gregdavill/gpsLogger/README.md

# gpsLogger

MSP430F55xx based GPS logger, with USB MSC for log retrieval
