gregdavill/gpsLogger/fw/gpsLoggerBootloader/Memory Map.png

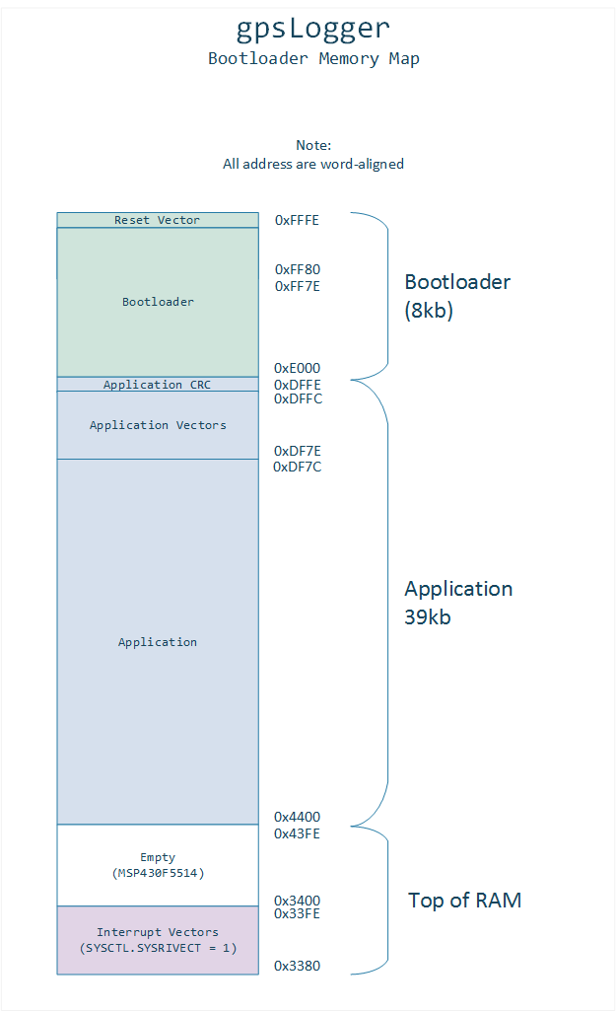
fw/gpsLoggerBootloader/Memory Map.png
