gregdavill/gpsLogger/hw/v2.3.a/3d/FH34SRJ-6S-0.5SH.igs

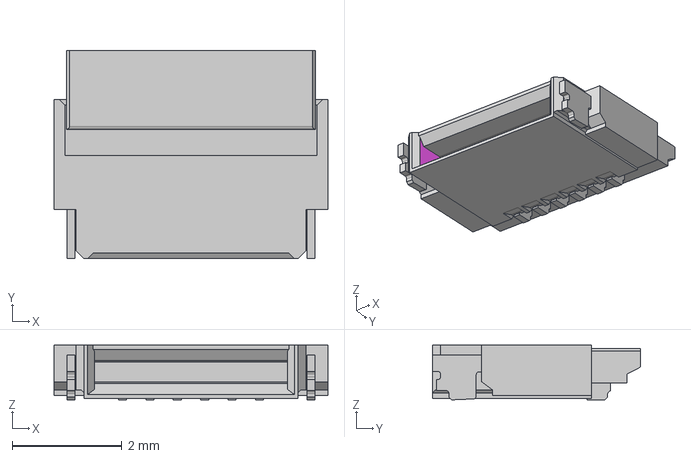
[picture p2: CAD file, 2021-10-18]
hw/v2.3.a/3d/FH34SRJ-6S-0.5SH.igs
5.00 x 3.80 x 1.00 mm
