gregdavill/gpsLogger/hw/v2.3.a/3d/EVQ-P1-9FKYD_P04_9P1-05M.STEP

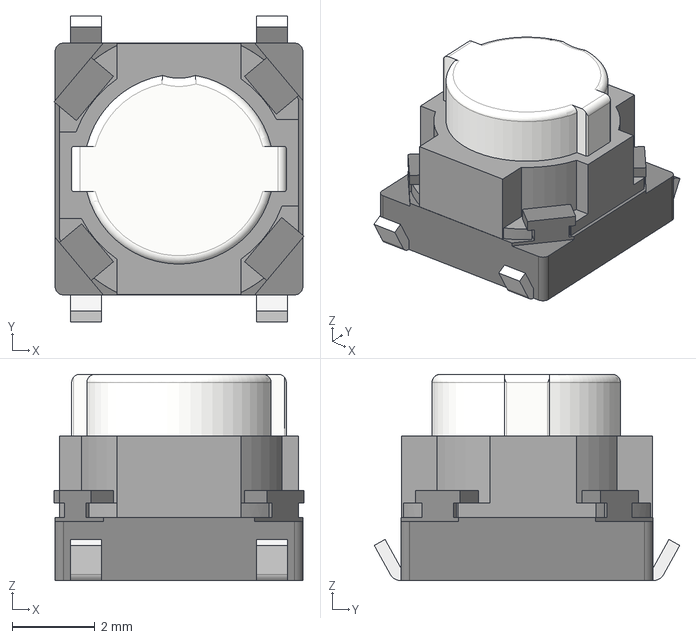
[picture p3: CAD file, 2021-10-18]
hw/v2.3.a/3d/EVQ-P1-9FKYD_P04_9P1-05M.STEP
6.06 x 7.40 x 5.00 mm
