gregdavill/gpsLogger/hw/v2.3.a/3d/10132328_usbc_vertical.step

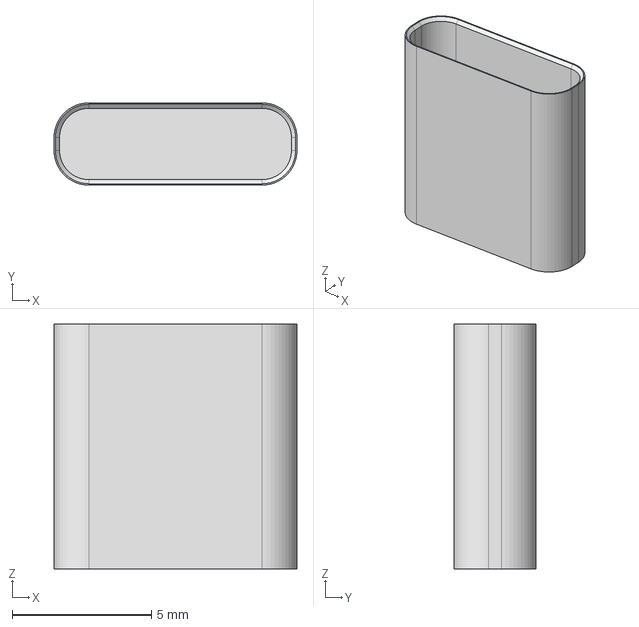
[picture p4: CAD file, 2021-10-18]
hw/v2.3.a/3d/10132328_usbc_vertical.step
8.74 x 2.96 x 8.80 mm
