gregdavill/gpsLogger/hw/v2.3.a/main-board/gps-logger-main-sch.pdf

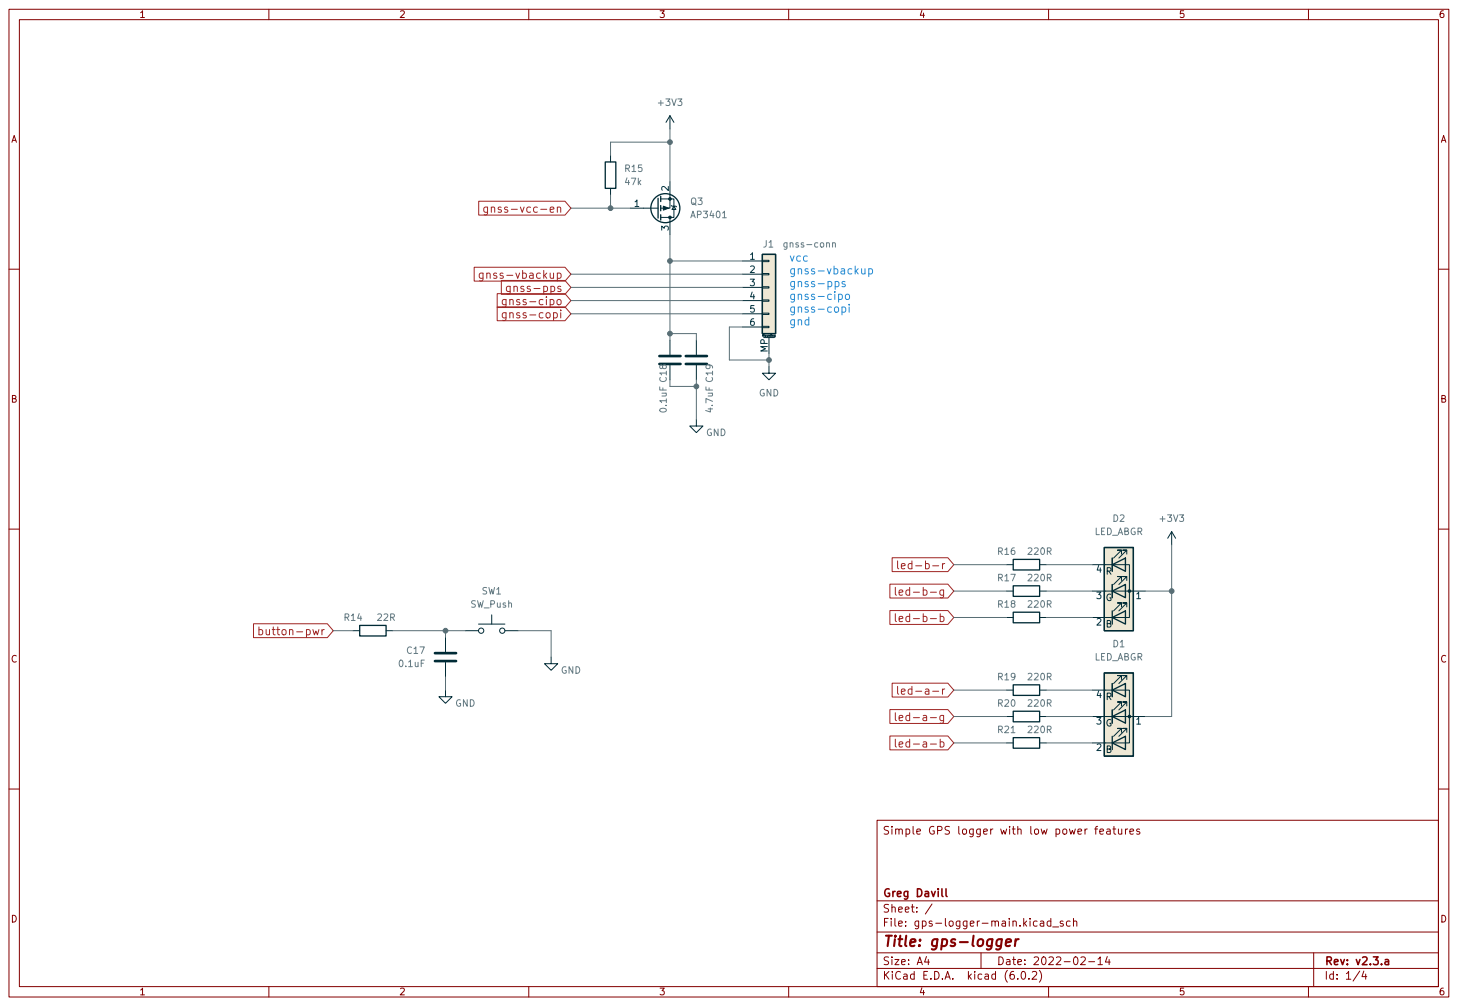
[picture p5: page 1]

Simple GPS logger with low power features

File: gps-logger-main.kicad_sch Sheet: / Greg Davill

Id: 1/4 Title: gps-logger

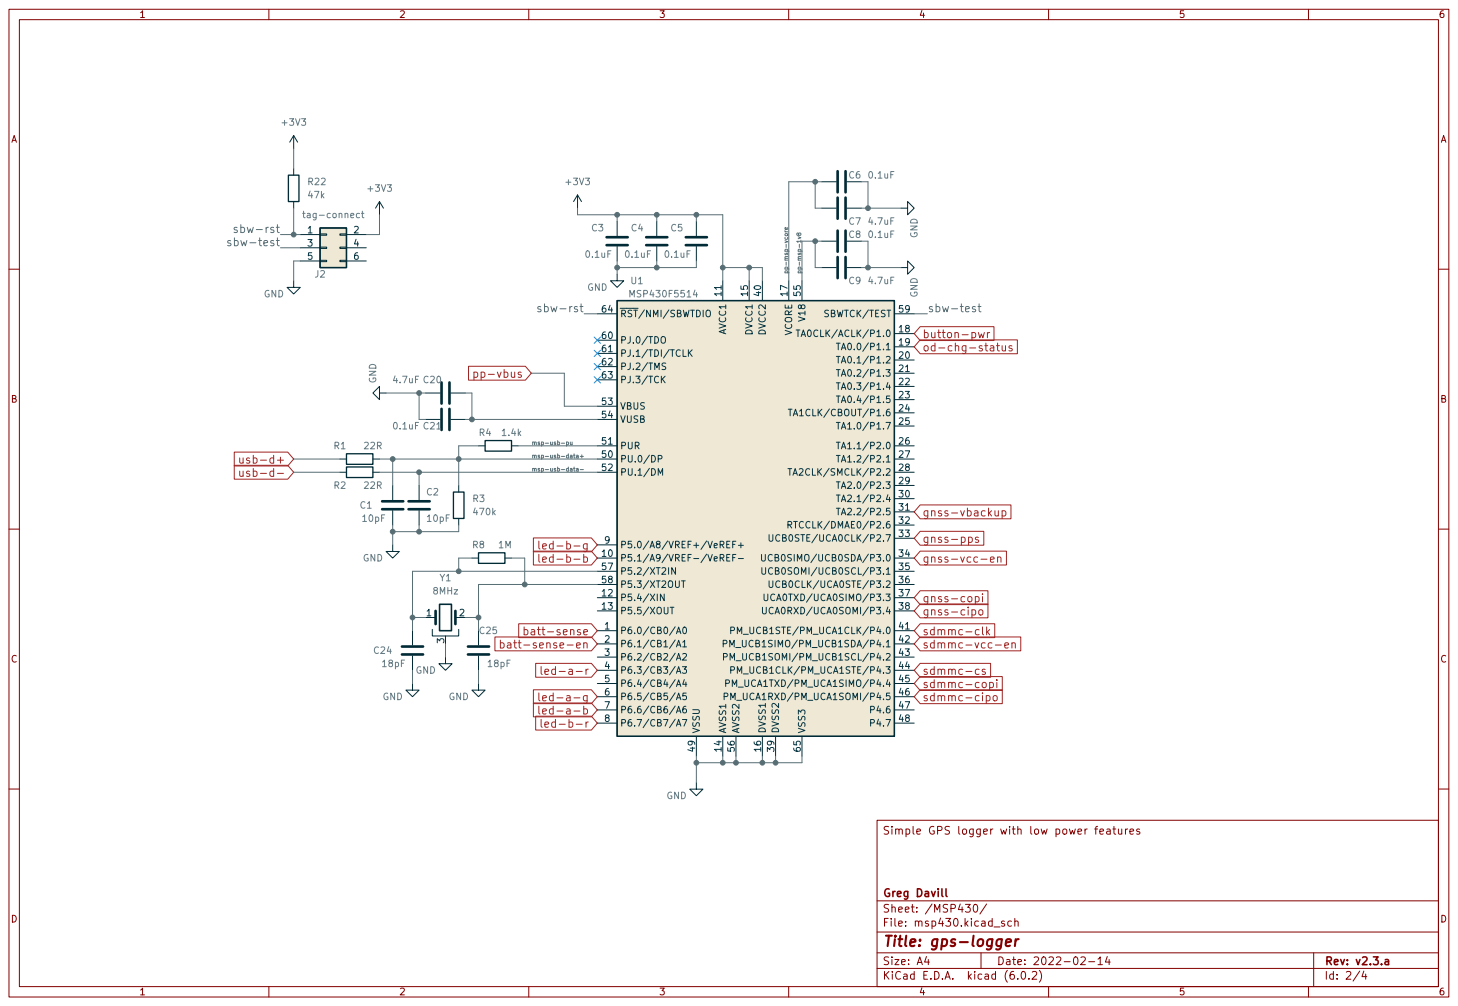
[picture p6: page 2]

pp-vbusbatt-sense-en

Simple GPS logger with low power features C2

File: msp430.kicad_sch Sheet: /MSP430/ Greg Davill

Id: 2/4 Title: gps-logger

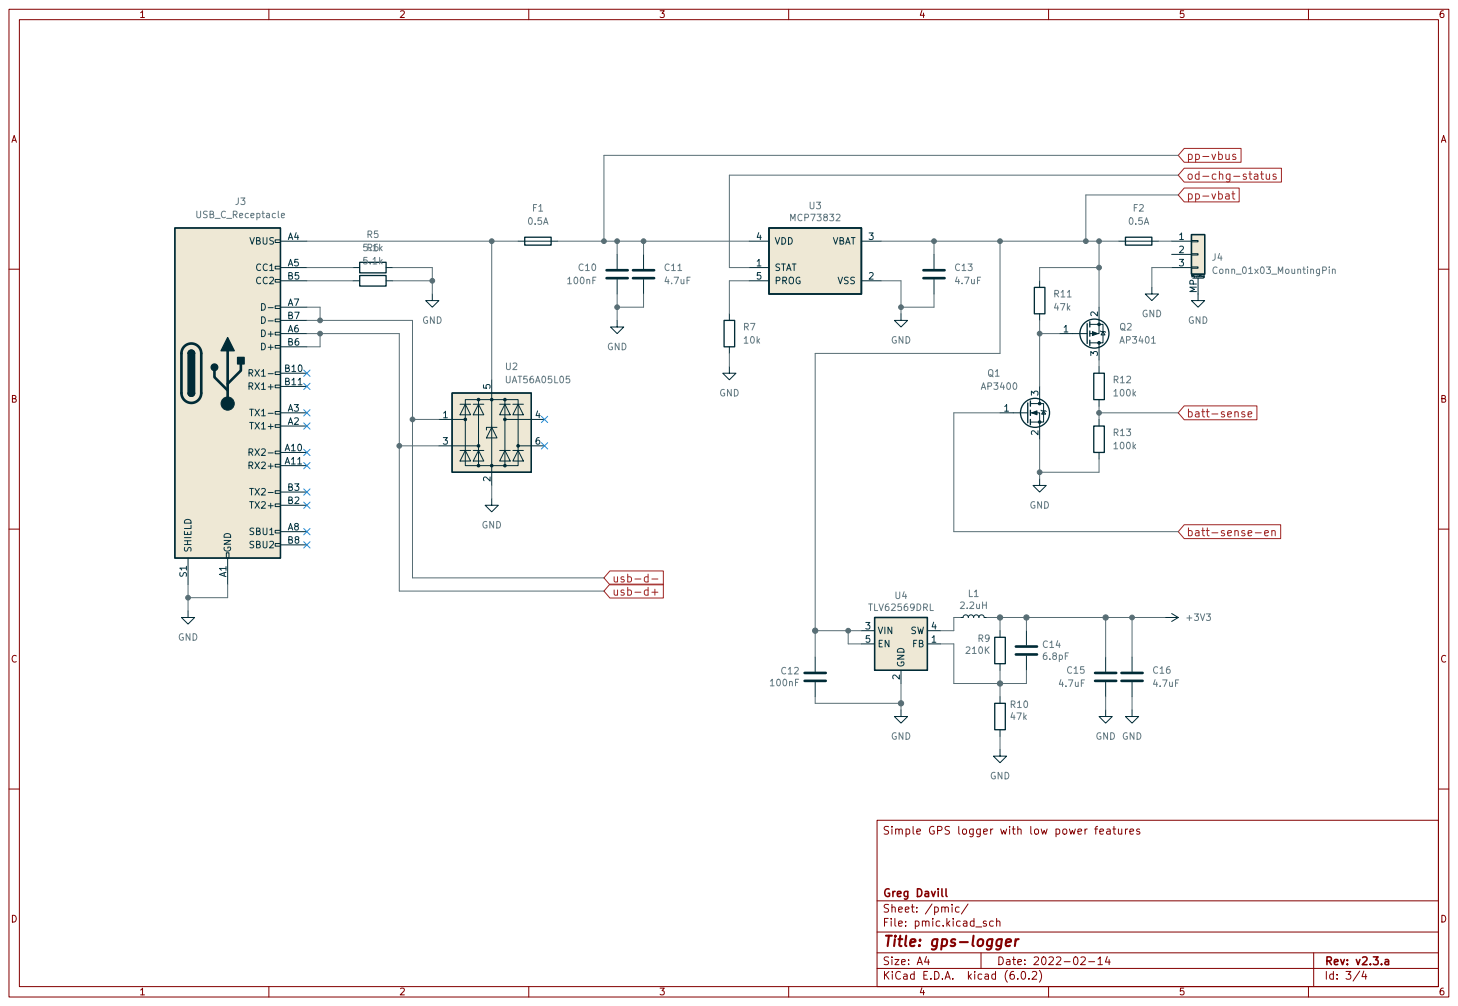
[picture p7: page 3]

pp-vbus
od-chg-status batt-sense-en

2 VIN 3 SW 4 EN 5 U4 TLV62569DRL GND A1 RX2- A10 RX2+ A11 TX1+ A2 TX1- A3 VBUS A4 CC1 A5 D+ A6 D- A7 SBU1 A8 RX1- B10 RX1+ B11 TX2+ B2 TX2- B3 CC2 B5 D+ B6 D- B7 SBU2 B8 SHIELD S1

Simple GPS logger with low power features C14

Greg Davill
Sheet: /pmic/
File: pmic.kicad_sch
Id: 3/4 Title: gps-logger

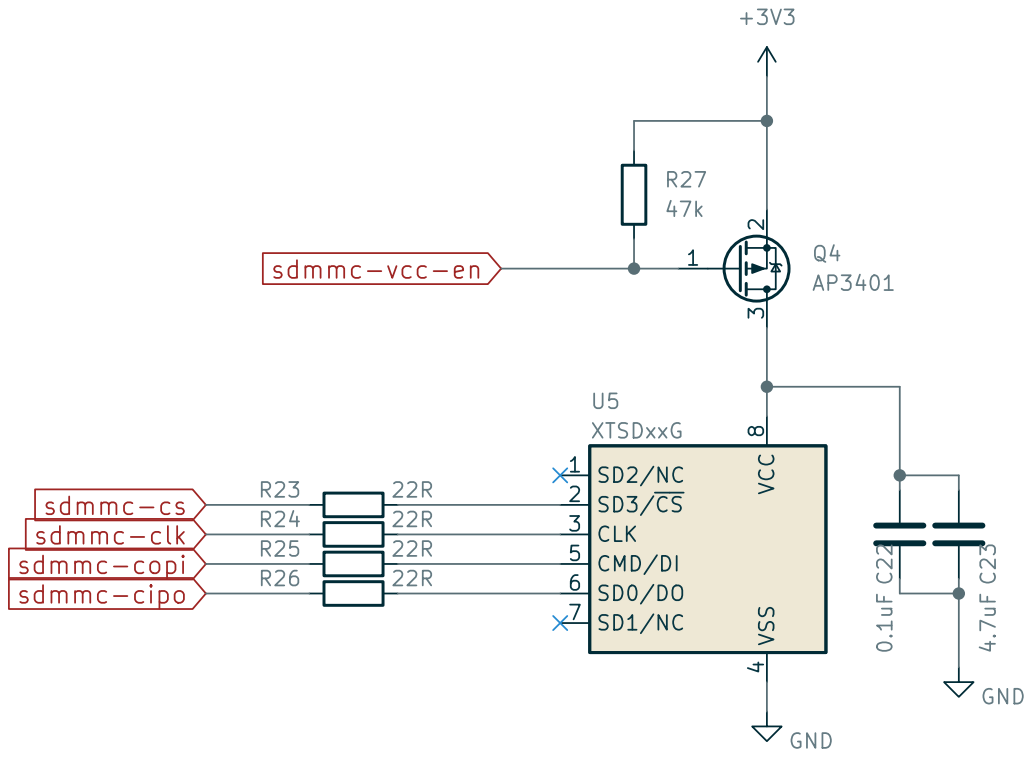
[picture p8: page 4]

4 CMD/DI 5 SD0/DO 6 SD1/NC 7 VCC

Simple GPS logger with low power features

File: sdmmc.kicad_sch Sheet: /sdmmc/ Greg Davill

Id: 4/4 Title: gps-logger
