gregdavill/gpsLogger/hw/v2.1/gpsLogger.pdf

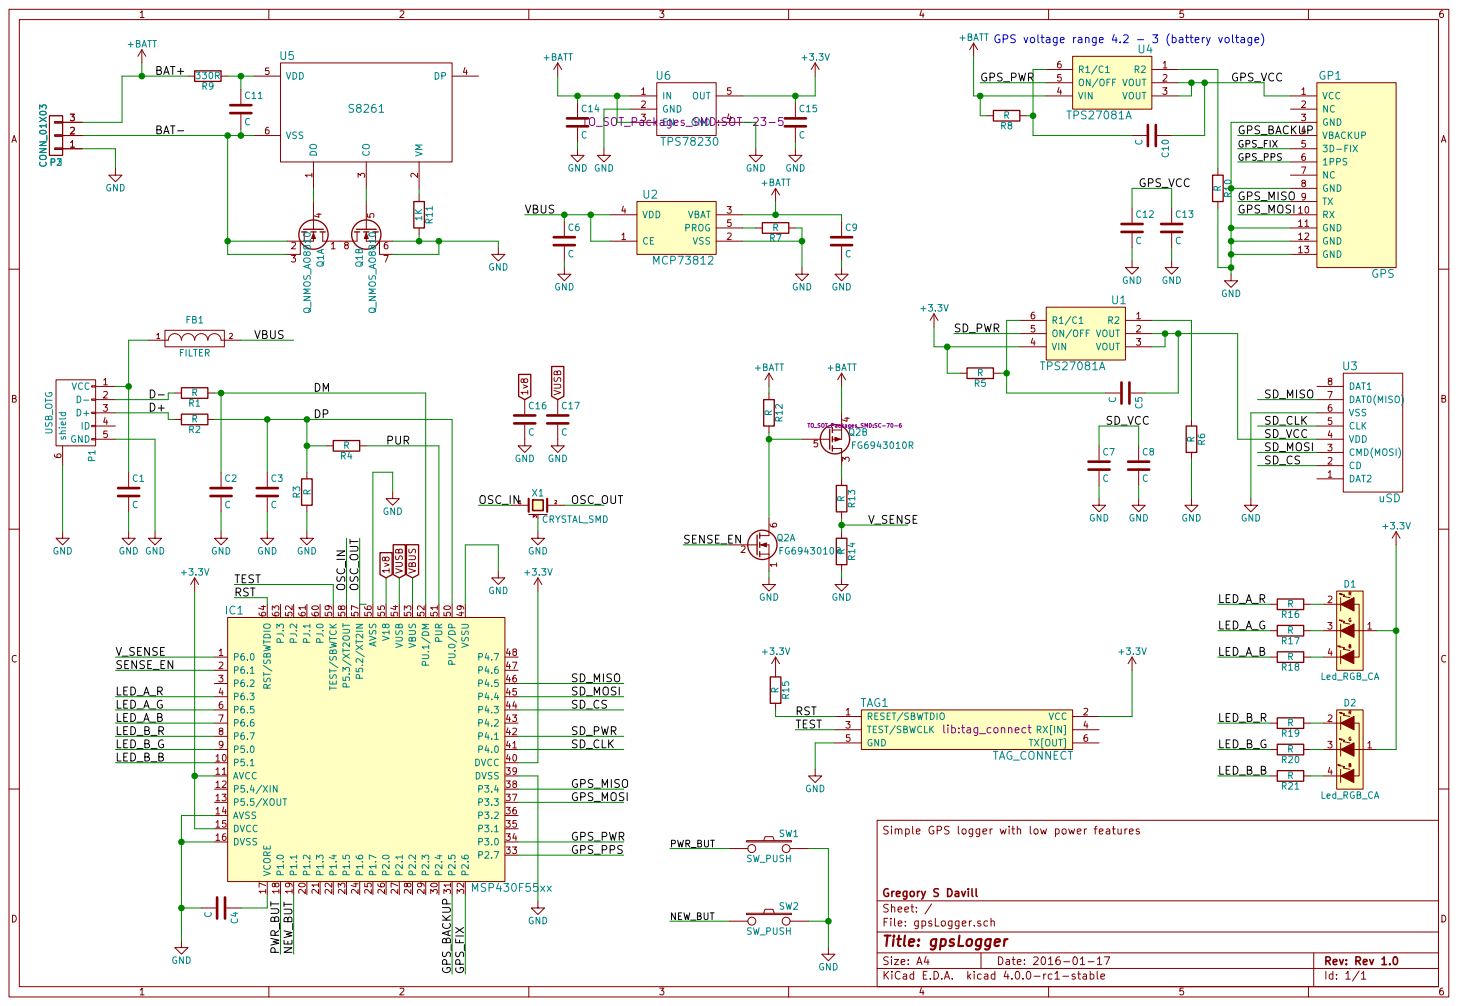
[picture p9: page 1]

+BATT GPS voltage range 4.2 - 3 (battery voltage)

LED_A_B | SD_PWR
LED_B_R
LED_B_G
LED_B_B

Simple GPS logger with low power features

File: gpsLogger.sch Sheet: / Gregory S Davill
