gregdavill/gpsLogger/hw/v2.3.a/main-board/gps-logger-main.kicad_pcb

## KiCad design hw/v2.3.a/main-board/gps-logger-main.kicad_pcb (2022-02-14)

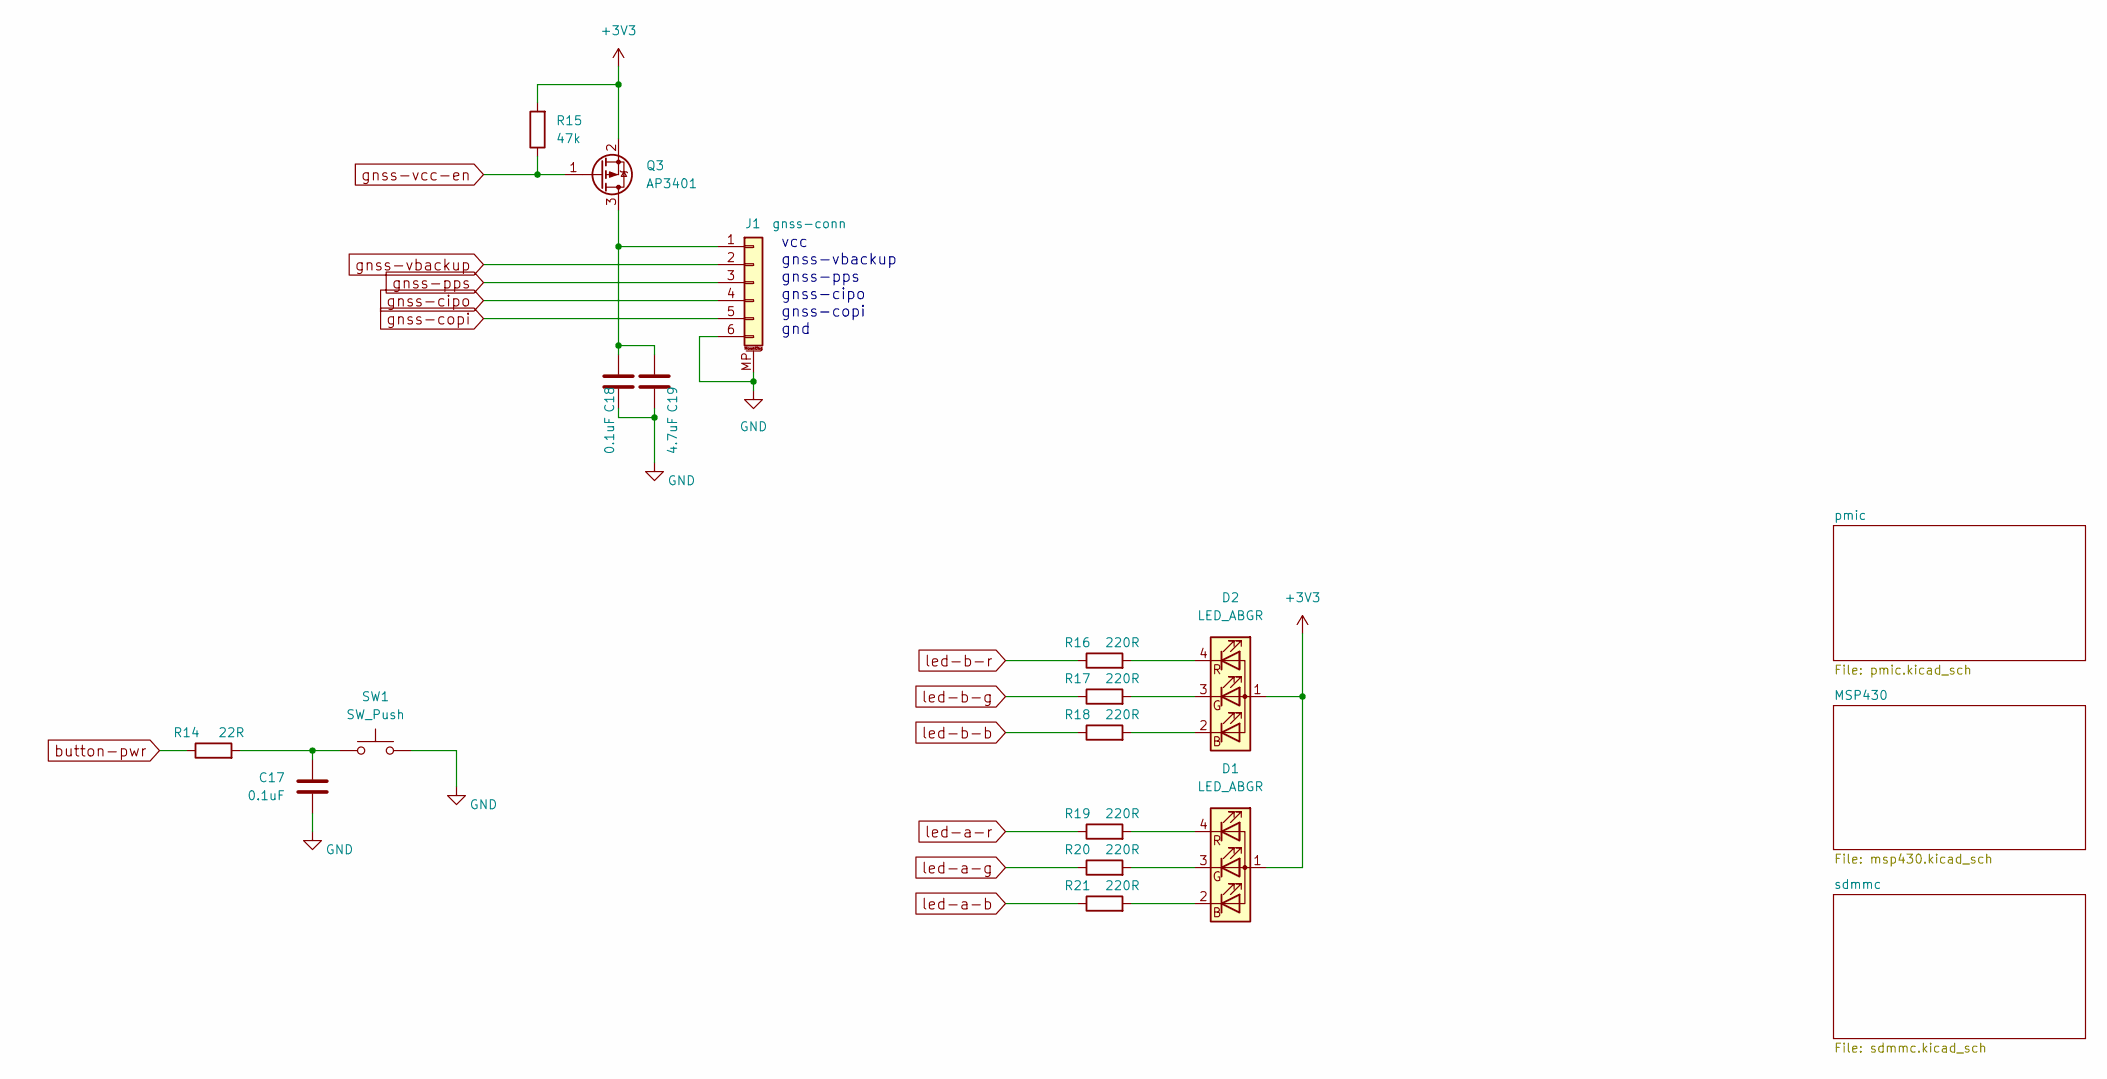
[picture p10: schematic gps-logger-main.kicad_sch, gps-logger]

Parts:
C17, C18: 0.1uF; C_0402_1005Metric
C19: 4.7uF; C_0402_1005Metric
D1, D2: LED_ABGR; 0404LED_RGB
J1: gnss-conn; Hirose_FH34SRJ-16S-0.5SH_1x16-1MP_P0.50mm_Horizontal
Q3: AP3401; SOT-23
R14: 22R; R_0402_1005Metric
R15: 47k; R_0402_1005Metric
R16, R17, R18, R19, R20, R21: 220R; R_0402_1005Metric
SW1: SW_Push; EVQ_switch

Connections:
+3V3: D1.1 (A), D2.1 (A), Q3.2 (S), R15.2; also elsewhere on the board
GND: C17.1, C18.1, C19.2, J1.6, J1.MP (MountPin), SW1.2; also elsewhere on the board
unnamed: C17.2, R14.2, SW1.1
unnamed: C18.2, C19.1, J1.1, Q3.3 (D)
unnamed: D1.2 (BK), R21.2
unnamed: D1.3 (GK), R20.2
unnamed: D1.4 (RK), R19.2
unnamed: D2.2 (BK), R18.2
unnamed: D2.3 (GK), R17.2
unnamed: D2.4 (RK), R16.2
button-pwr: R14.1; also elsewhere on the board
gnss-cipo: J1.4; also elsewhere on the board
gnss-copi: J1.5; also elsewhere on the board
gnss-pps: J1.3; also elsewhere on the board
gnss-vbackup: J1.2; also elsewhere on the board
gnss-vcc-en: Q3.1 (G), R15.1; also elsewhere on the board
led-a-b: R21.1; also elsewhere on the board
led-a-g: R20.1; also elsewhere on the board
led-a-r: R19.1; also elsewhere on the board
led-b-b: R18.1; also elsewhere on the board
led-b-g: R17.1; also elsewhere on the board
led-b-r: R16.1; also elsewhere on the board

Notes on the sheet:
vcc gnss-vbackup gnss-pps gnss-cipo gnss-copi gnd

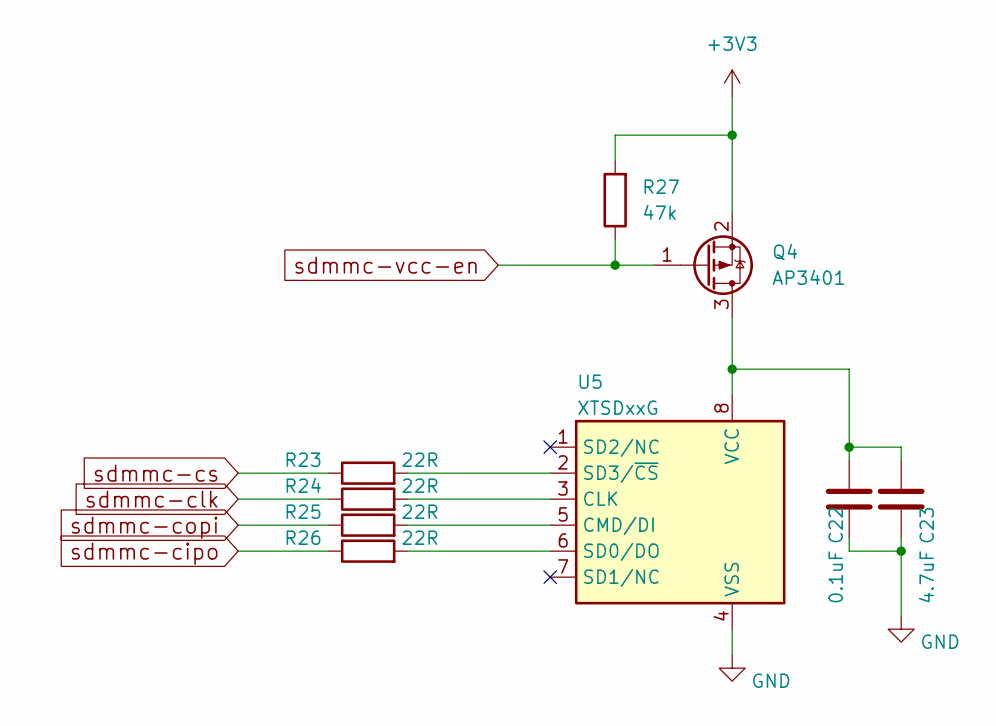
[picture p11: schematic sdmmc.kicad_sch, gps-logger]

Parts:
C22: 0.1uF; C_0402_1005Metric
C23: 4.7uF; C_0402_1005Metric
Q4: AP3401; SOT-23
R23, R24, R25, R26: 22R; R_0402_1005Metric
R27: 47k; R_0402_1005Metric
U5: XTSDxxG; LGA-8_8x6_Pitch1.27mm

Connections:
+3V3: Q4.2 (S), R27.2; also elsewhere on the board
GND: C22.1, C23.2, U5.4 (VSS); also elsewhere on the board
unnamed: C22.2, C23.1, Q4.3 (D), U5.8 (VCC)
unnamed: R23.2, U5.2 (SD3/~CS)
unnamed: R24.2, U5.3 (CLK)
unnamed: R25.2, U5.5 (CMD/DI)
unnamed: R26.2, U5.6 (SD0/DO)
sdmmc-cipo: R26.1; also elsewhere on the board
sdmmc-clk: R24.1; also elsewhere on the board
sdmmc-copi: R25.1; also elsewhere on the board
sdmmc-cs: R23.1; also elsewhere on the board
sdmmc-vcc-en: Q4.1 (G), R27.1; also elsewhere on the board

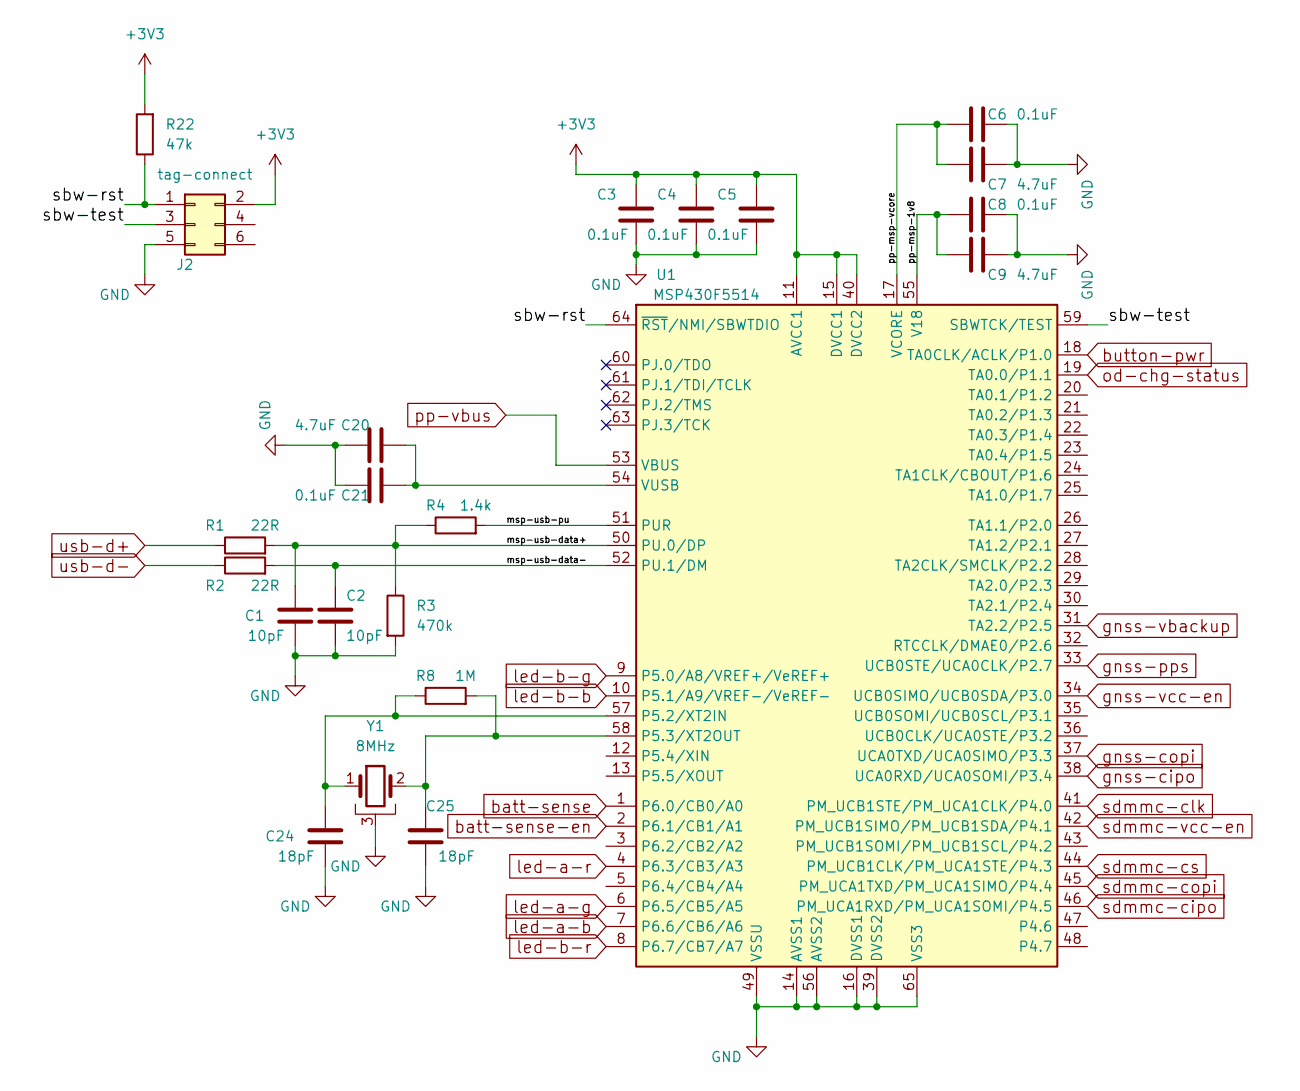
[picture p12: schematic msp430.kicad_sch, gps-logger]

Parts:
C1, C2: 10pF; C_0402_1005Metric
C3, C4, C5, C6, C8, C21: 0.1uF; C_0402_1005Metric
C7, C9, C20: 4.7uF; C_0402_1005Metric
C24, C25: 18pF; C_0402_1005Metric
J2: tag-connect; TC2030-NL_SMALL
R1, R2: 22R; R_0402_1005Metric
R3: 470k; R_0402_1005Metric
R4: 1.4k; R_0402_1005Metric
R8: 1M; R_0402_1005Metric
R22: 47k; R_0402_1005Metric
U1: MSP430F5514; QFN-64-1EP_9x9mm_P0.5mm_EP4.35x4.35mm
Y1: 8MHz; Crystal_SMD_Abracon_ABM8G-4Pin_3.2x2.5mm

Connections:
+3V3: C3.1, C4.1, C5.1, J2.2, R22.2, U1.11 (AVCC1), U1.15 (DVCC1), U1.40 (DVCC2); also elsewhere on the board
/MSP430/msp-usb-data+: C1.1, R1.2, R3.1, R4.1, U1.50 (PU.0/DP)
/MSP430/msp-usb-data-: C2.1, R2.2, U1.52 (PU.1/DM)
/MSP430/msp-usb-pu: R4.2, U1.51 (PUR)
/MSP430/pp-msp-1v8: C8.2, C9.1, U1.55 (V18)
/MSP430/pp-msp-vcore: C6.2, C7.1, U1.17 (VCORE)
/MSP430/sbw-rst: J2.1, R22.1, U1.64 (~RST/NMI/SBWTDIO)
/MSP430/sbw-test: J2.3, U1.59 (SBWTCK/TEST)
GND: C1.2, C2.2, C3.2, C4.2, C5.2, C6.1, C7.2, C8.1, C9.2, C20.2, C21.1, C24.2, C25.2, J2.5, R3.2, U1.14 (AVSS1), U1.16 (DVSS1), U1.39 (DVSS2), U1.49 (VSSU), U1.56 (AVSS2), U1.65 (VSS3), Y1.3; also elsewhere on the board
unnamed: C20.1, C21.2, U1.54 (VUSB)
unnamed: C24.1, R8.1, U1.57 (P5.2/XT2IN), Y1.1
unnamed: C25.1, R8.2, U1.58 (P5.3/XT2OUT), Y1.2
batt-sense: U1.1 (P6.0/CB0/A0); also elsewhere on the board
batt-sense-en: U1.2 (P6.1/CB1/A1); also elsewhere on the board
button-pwr: U1.18 (TA0CLK/ACLK/P1.0); also elsewhere on the board
gnss-cipo: U1.38 (UCA0RXD/UCA0SOMI/P3.4); also elsewhere on the board
gnss-copi: U1.37 (UCA0TXD/UCA0SIMO/P3.3); also elsewhere on the board
gnss-pps: U1.33 (UCB0STE/UCA0CLK/P2.7); also elsewhere on the board
gnss-vbackup: U1.31 (TA2.2/P2.5); also elsewhere on the board
gnss-vcc-en: U1.34 (UCB0SIMO/UCB0SDA/P3.0); also elsewhere on the board
led-a-b: U1.7 (P6.6/CB6/A6); also elsewhere on the board
led-a-g: U1.6 (P6.5/CB5/A5); also elsewhere on the board
led-a-r: U1.4 (P6.3/CB3/A3); also elsewhere on the board
led-b-b: U1.10 (P5.1/A9/VREF-/VeREF-); also elsewhere on the board
led-b-g: U1.9 (P5.0/A8/VREF+/VeREF+); also elsewhere on the board
led-b-r: U1.8 (P6.7/CB7/A7); also elsewhere on the board
od-chg-status: U1.19 (TA0.0/P1.1); also elsewhere on the board
pp-vbus: U1.53 (VBUS); also elsewhere on the board
sdmmc-cipo: U1.46 (PM_UCA1RXD/PM_UCA1SOMI/P4.5); also elsewhere on the board
sdmmc-clk: U1.41 (PM_UCB1STE/PM_UCA1CLK/P4.0); also elsewhere on the board
sdmmc-copi: U1.45 (PM_UCA1TXD/PM_UCA1SIMO/P4.4); also elsewhere on the board
sdmmc-cs: U1.44 (PM_UCB1CLK/PM_UCA1STE/P4.3); also elsewhere on the board
sdmmc-vcc-en: U1.42 (PM_UCB1SIMO/PM_UCB1SDA/P4.1); also elsewhere on the board
usb-d+: R1.1; also elsewhere on the board
usb-d-: R2.1; also elsewhere on the board

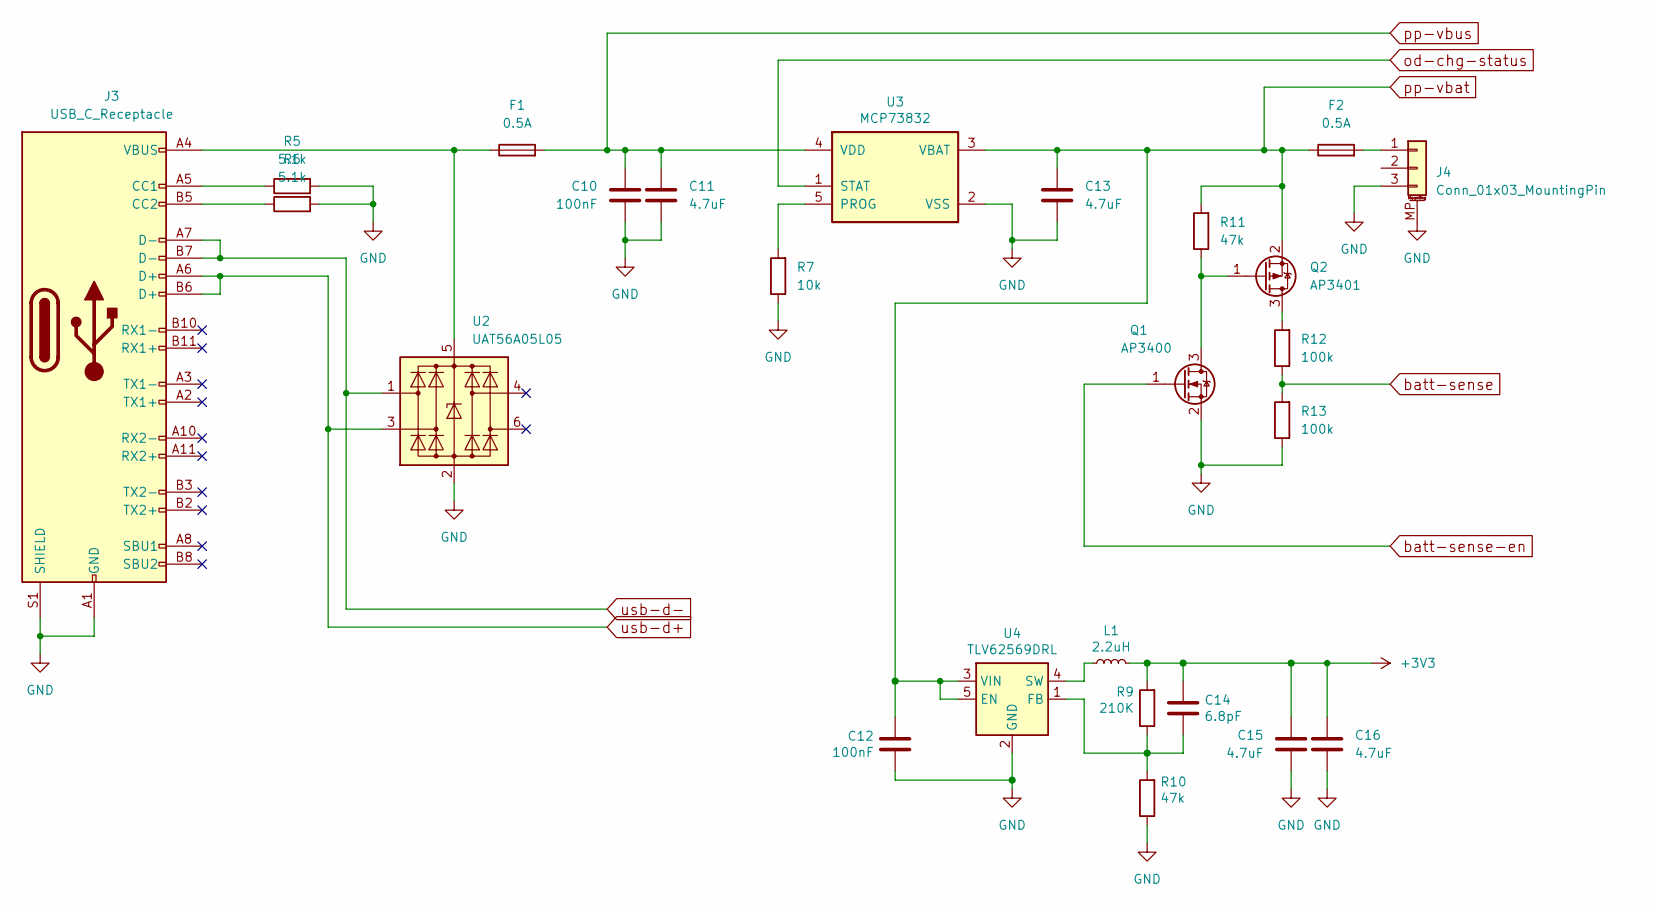
[picture p13: schematic pmic.kicad_sch, gps-logger]

Parts:
C10, C12: 100nF; C_0402_1005Metric
C11, C13, C15, C16: 4.7uF; C_0402_1005Metric
C14: 6.8pF; C_0402_1005Metric
F1, F2: 0.5A; Fuse_0402_1005Metric
J3: USB_C_Receptacle; usbc_vert_10132328
J4: Conn_01x03_MountingPin; JST_GH_SM03B-GHS-TB_1x03-1MP_P1.25mm_Horizontal
L1: 2.2uH; L_0805_2012Metric
Q1: AP3400; SOT-23
Q2: AP3401; SOT-23
R5, R6: 5.1k; R_0402_1005Metric
R7: 10k; R_0402_1005Metric
R9: 210K; R_0402_1005Metric
R10, R11: 47k; R_0402_1005Metric
R12, R13: 100k; R_0402_1005Metric
U2: UAT56A05L05; SOT-666
U3: MCP73832; SOT-23-5
U4: TLV62569DRL; SOT-666

Connections:
+3V3: C14.1, C15.1, C16.1, L1.2, R9.2; also elsewhere on the board
GND: C10.2, C11.2, C12.2, C13.2, C15.2, C16.2, J3.A1 (GND), J3.A12 (GND), J3.B1 (GND), J3.B12 (GND), J3.S1 (SHIELD), J4.3, J4.MP (MountPin), Q1.2 (S), R5.2, R6.2, R7.1, R10.1, R13.1, U2.2 (GND), U3.2 (VSS), U4.2 (GND); also elsewhere on the board
unnamed: C14.2, R9.1, R10.2, U4.1 (FB)
unnamed: F1.1, J3.A4 (VBUS), J3.A9 (VBUS), J3.B4 (VBUS), J3.B9 (VBUS), U2.5 (VBUS)
unnamed: F2.2, J4.1
unnamed: J3.A5 (CC1), R5.1
unnamed: J3.B5 (CC2), R6.1
unnamed: L1.1, U4.4 (SW)
unnamed: Q1.3 (D), Q2.1 (G), R11.1
unnamed: Q2.3 (D), R12.2
unnamed: R7.2, U3.5 (PROG)
batt-sense: R12.1, R13.2; also elsewhere on the board
batt-sense-en: Q1.1 (G); also elsewhere on the board
od-chg-status: U3.1 (STAT); also elsewhere on the board
pp-vbat: C12.1, C13.1, F2.1, Q2.2 (S), R11.2, U3.3 (VBAT), U4.3 (VIN), U4.5 (EN)
pp-vbus: C10.1, C11.1, F1.2, U3.4 (VDD); also elsewhere on the board
usb-d+: J3.A6 (D+), J3.B6 (D+), U2.3 (I/O2); also elsewhere on the board
usb-d-: J3.A7 (D-), J3.B7 (D-), U2.1 (I/O1); also elsewhere on the board

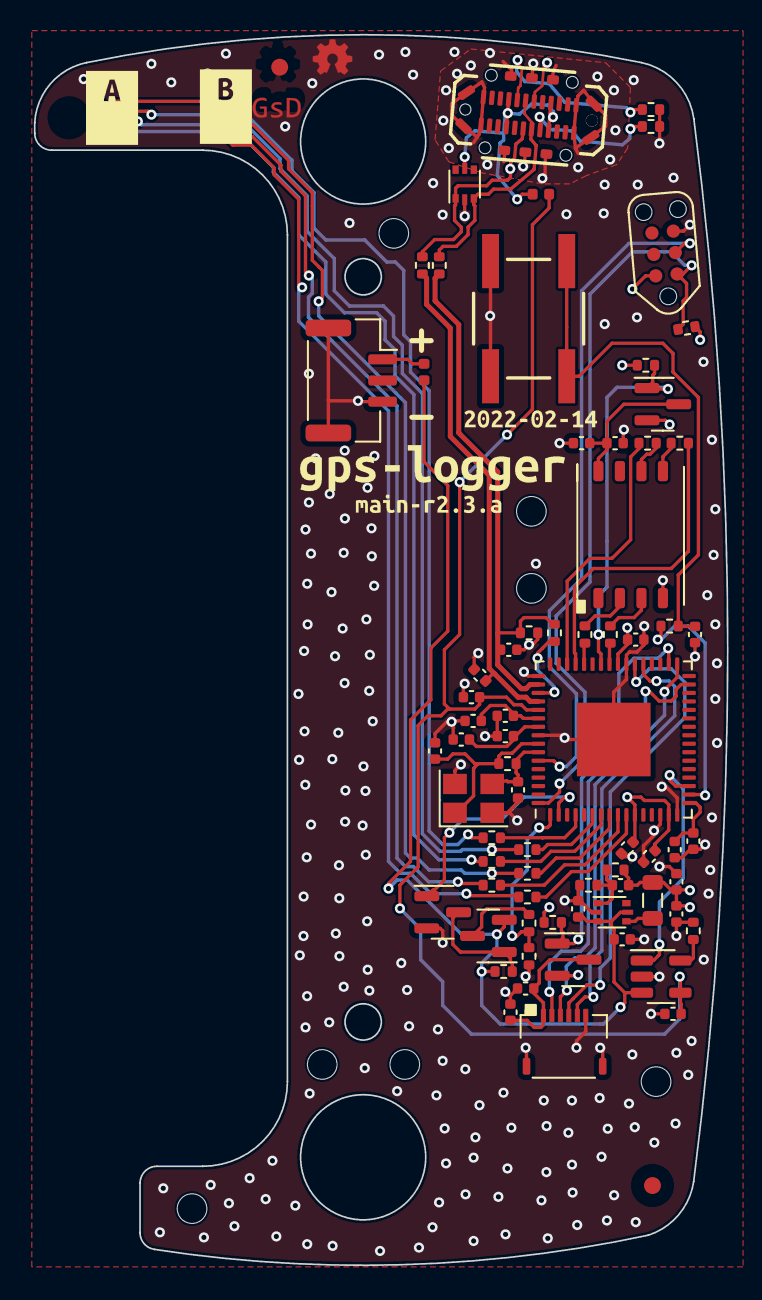
[picture p14: board gps-logger-main.kicad_pcb from above]

Board: 4 copper layers, 40.9 x 72.7 mm, 77 parts (0 on the bottom side), 58 nets.

Other parts of the board:
kibuzzard-616D4B20: G***; kibuzzard-616D4B20
kibuzzard-6209DBB7: G***; kibuzzard-6209DBB7
kibuzzard-6209DBEB: G***; kibuzzard-6209DBEB
kibuzzard-6209DC67: G***; kibuzzard-6209DC67
kibuzzard-6209DC92: G***; kibuzzard-6209DC92
