gregdavill/gpsLogger/hw/v2.3/gnss-board/gps-logger-gnss.kicad_pcb

## KiCad design hw/v2.3/gnss-board/gps-logger-gnss.kicad_pcb (2021-10-19)

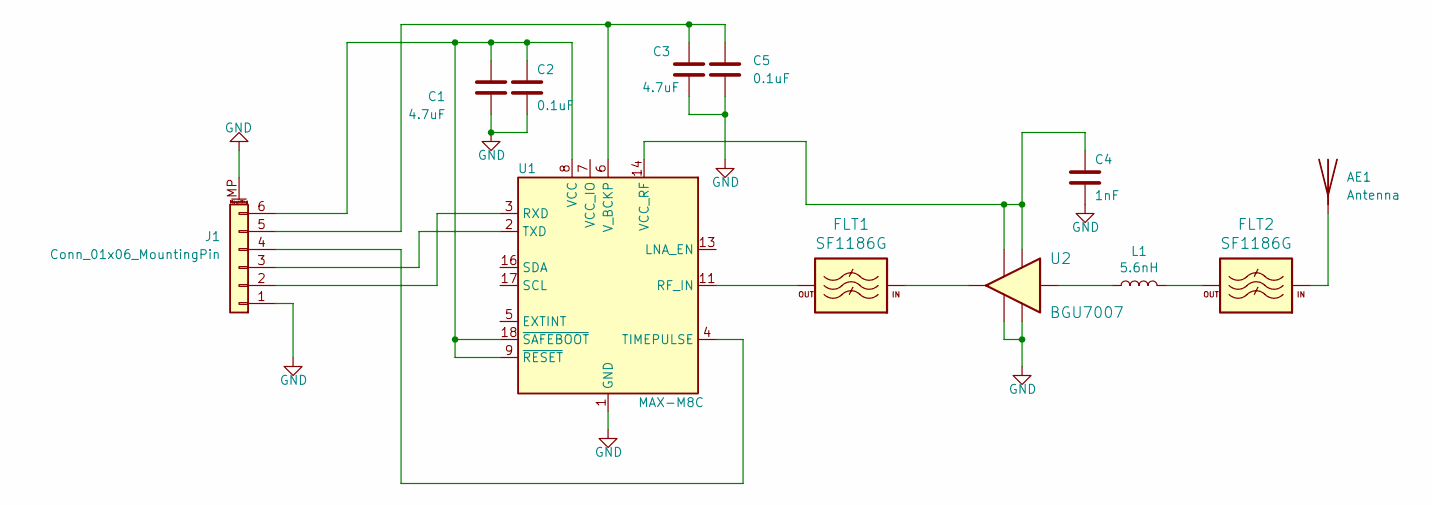
[picture p15: schematic gps-logger-gnss.kicad_sch, gps-logger gnss board]

Parts:
AE1: Antenna
C1, C3: 4.7uF; C_0402_1005Metric
C2, C5: 0.1uF; C_0402_1005Metric
C4: 1nF; C_0402
FLT1, FLT2: SF1186G; SAW-5
J1: Conn_01x06_MountingPin; Hirose_FH34SRJ-16S-0.5SH_1x16-1MP_P0.50mm_Horizontal
L1: 5.6nH; L_0402
U1: MAX-M8C; ublox_MAX
U2: BGU7007; XSON6

Connections:
GND: C1.2, C2.2, C3.2, C4.2, C5.2, FLT1.2, FLT1.4, FLT1.5, FLT2.2, FLT2.4, FLT2.5, J1.1, J1.MP (MountPin), U1.1 (GND), U1.10 (GND), U1.12 (GND), U2.4 (VCC), U2.5 (ENABLE)
unnamed 1: AE1.1, FLT2.1 (INPUT); also elsewhere on the board
unnamed: C1.1, C2.1, J1.6, U1.8 (VCC), U1.9 (~RESET), U1.18 (~SAFEBOOT)
unnamed: C3.1, C5.1, J1.5, U1.6 (V_BCKP)
unnamed: C4.1, U1.14 (VCC_RF), U2.1 (GND), U2.2 (GND)
unnamed: FLT1.1 (INPUT), U2.6 (RF_O)
unnamed: FLT1.3 (OUTPUT), U1.11 (RF_IN)
unnamed: FLT2.3 (OUTPUT), L1.2
unnamed: J1.2, U1.3 (RXD)
unnamed: J1.3, U1.2 (TXD)
unnamed: J1.4, U1.4 (TIMEPULSE)
unnamed: L1.1, U2.3 (RF_IN)

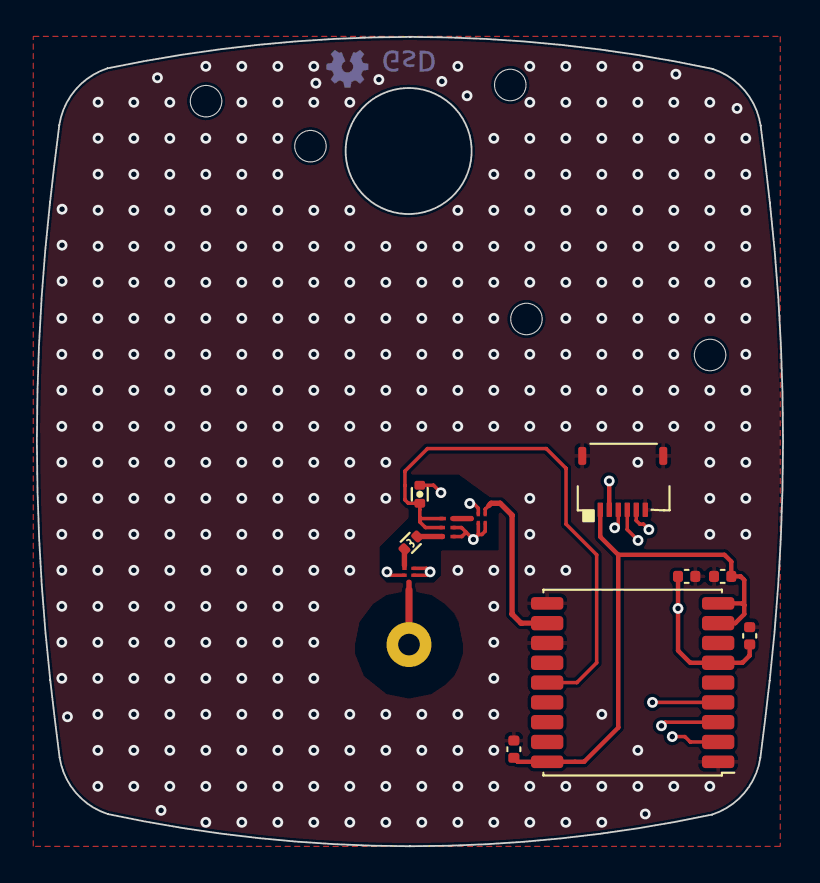
[picture p16: board gps-logger-gnss.kicad_pcb from above]

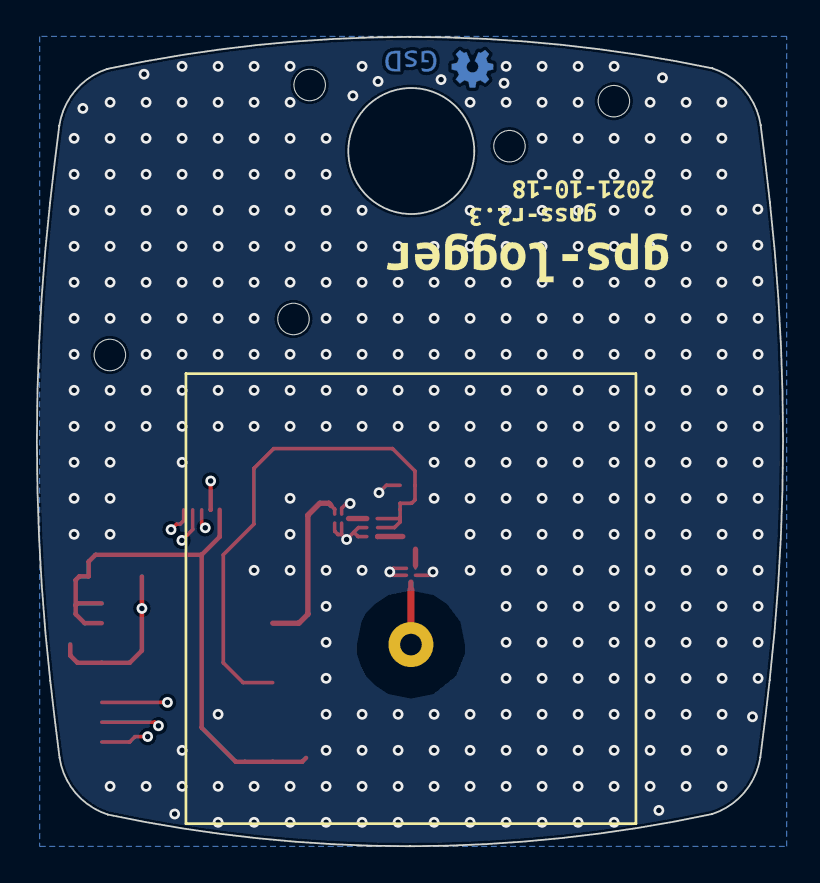
[picture p17: board gps-logger-gnss.kicad_pcb from below]

Board: 4 copper layers, 41.5 x 45.0 mm, 15 parts (4 on the bottom side), 12 nets.

Other parts of the board:
ANT1: pkl_PATCH_ANTENNA; GPS_ANT
kibuzzard-616D57EE: G***; kibuzzard-616D57EE
kibuzzard-616D5807: G***; kibuzzard-616D5807
kibuzzard-616D5817: G***; kibuzzard-616D5817

Their connections:
unnamed 1: ANT1.1; also elsewhere on the board
