gregdavill/gpsLogger/hw/v2.1/gpsLogger.kicad_pcb

## KiCad design hw/v2.1/gpsLogger.kicad_pcb (2018-07-03, an earlier design)

Schematic: gpsLogger.kicad_sch

Parts:
ANT1: ANT; GPS_ANT
C1, C5, C7, C12: 10n; C_0603
C2, C3: 22p; C_0603
C4, C8, C13, C16, C17: 1uF; C_0603
C6, C9, C14, C15: C; C_0603
C10, C11, C18: 100n; C_0603
C19, C21, C22: 47pF; C_0603
C20: 1nF; C_0603
D1, D2: Led_RGB_CA; LITEON_RGB
FB1: 1k FB; R_0603
FLT1: B8813; SAW-5
IC1: MSP430F55xx; QFN-64-1EP_9x9mm_Pitch0.5mm
L1: 27nH; C_0603
L2, L3: 100nH; C_0603
L4: 5.6nH; C_0402
P1: USB_OTG; USB_VERT
P2: CONN_01X02; BM02B-GHS-TBT
Q2: FG6943010R; SC-70-6
R1, R2: 27R; R_0603
R3: 470k; R_0603
R4: 1k4; R_0603
R5, R8, R9, R11: 10k; R_0603
R6: 10R; R_0603
R7, R12, R13, R14, R15, R16, R17, R18, R19, R20, R21: R; R_0603
R10: 1k; R_0603
R22, R23, R24, R25, R26, R27, R28: 2k2; R_0603
SW1: SW_PUSH; EVQ_switch
TAG1: TAG_CONNECT; tag_connect
U1: MAX_M8Q; MAX_M8
U2: MCP73812; SOT-23-5
U3: uSD; SD_holder_472190001
U4, U5: MIC2091; SOT-23-5
U6: TPS78230; SOT-23-5
U7: BGU7007; XSON6
X1: CRYSTAL_SMD; CSTCR_G15C

Connections:
1v8: C16.1, IC1.55 (V18)
+3V3: C15.1, D1.1, D2.1, IC1.11 (AVCC), IC1.15 (DVCC), IC1.40 (DVCC), R9.2, R11.2, R15.1, TAG1.2 (VCC), U4.1 (IN), U5.1 (IN), U6.5 (OUT)
+BATT: C9.1, C14.1, P2.1, Q2.4 (D), R12.1, U2.3 (VBAT), U6.1 (IN), U6.3 (EN)
/ANT_RF: ANT1.1, C19.2
/LED_A_B: IC1.7 (P6.6), R18.2
/LED_A_G: IC1.6 (P6.5), R17.2
/LED_A_R: IC1.4 (P6.3), R16.2
/LED_B_B: IC1.10 (P5.1), R21.2
/LED_B_G: IC1.9 (P5.0), R20.2
/LED_B_R: IC1.8 (P6.7), R19.2
/OSC_IN: IC1.58 (P5.3/XT2OUT), X1.1
/OSC_OUT: IC1.57 (P5.2/XT2IN), X1.2
/PUR: IC1.51 (PUR), R4.1
/RST: IC1.64 (RST/SBWTDIO), R15.2, TAG1.1 (RESET/SBWTDIO)
/SENSE_EN: IC1.2 (P6.1), Q2.2 (G)
/TEST: IC1.59 (TEST/SBWTCK), TAG1.3 (TEST/SBWCLK)
/USB_DATA_N: C2.1, IC1.52 (PJ.2), R1.1
/USB_DATA_P: C3.1, IC1.50 (PU.0/DP), R2.1, R3.2, R4.2
/USB_IN_N: P1.2, R1.2
/USB_IN_P: P1.3, R2.2
/V_SENSE: IC1.1 (P6.0), R13.2, R14.1
GND: C1.2, C2.2, C3.2, C4.2, C5.2, C6.2, C7.2, C8.2, C9.2, C10.2, C11.2, C12.2, C13.2, C14.2, C15.2, C16.2, C17.2, C18.2, C20.2, FLT1.2, FLT1.3, FLT1.5, IC1.14 (AVSS), IC1.16 (DVSS), IC1.39 (DVSS), IC1.49 (VSSU), IC1.56 (AVSS), IC1.65, P1.5, P1.6, P2.2, Q2.1 (S), R3.1, R7.1, R14.2, SW1.2, TAG1.5 (GND), U1.1 (GND), U1.10 (GND), U1.12 (GND), U2.2 (VSS), U3.6 (VSS), U4.2 (GND), U5.2 (GND), U6.2 (GND), U6.4 (GND), U7.1 (GND), U7.2 (GND), X1.3
GPS_BACKUP: IC1.31 (P2.5), U1.6 (V_BCKP)
GPS_MISO: R26.2, U1.2 (TXD)
GPS_MOSI: R27.2, U1.3 (RXD)
GPS_PPS: R28.2, U1.4 (TIMEPULSE)
GPS_PWR: IC1.34 (P3.0), U4.3 (EN)
GPS_PWR_FAULT: IC1.35 (P3.1), R9.1, U4.4 (~FAULT)
GPS_RF_IN: C22.1, L1.2, U1.11 (RF_IN)
GPS_VCC: C10.1, C12.1, C13.1, L2.2, R5.2, R8.1, U1.7 (VCC_IO), U1.8 (VCC)
GPS_VCC_RF: C20.1, R6.1, U1.14 (VCC_RF), U7.4 (VCC), U7.5 (ENABLE)
MMC_CLK: R25.2, U3.5 (CLK)
MMC_CS: R24.2, U3.2 (CD)
MMC_MISO: R22.2, U3.7 (DAT0(MISO))
MMC_MOSI: R23.2, U3.3 (CMD(MOSI))
MMC_PWR: IC1.42 (P4.1), U5.3 (EN)
MMC_PWR_FAULT: IC1.43 (P4.2), R11.1, U5.4 (~FAULT)
MMC_VCC: C7.1, C8.1, C18.1, L3.2, U3.4 (VDD)
unnamed: C1.1, FB1.1, P1.1
unnamed: C4.1, IC1.17 (VCORE)
unnamed: C5.1, L1.1, R6.2
unnamed: C19.1, L4.1
unnamed: C21.1, FLT1.1 (INPUT)
unnamed: C21.2, U7.6 (RF_O)
unnamed: C22.2, FLT1.4 (OUTPUT)
unnamed: D1.2, R16.1
unnamed: D1.3, R17.1
unnamed: D1.4, R18.1
unnamed: D2.2, R19.1
unnamed: D2.3, R20.1
unnamed: D2.4, R21.1
unnamed: IC1.33 (P2.7), R28.1
unnamed: IC1.37 (P3.3), R27.1
unnamed: IC1.38 (P3.4), R26.1
unnamed: IC1.41 (P4.0), R25.1
unnamed: IC1.44 (P4.3), R24.1
unnamed: IC1.45 (P4.4), R23.1
unnamed: IC1.46 (P4.5), R22.1
unnamed: L2.1, U4.5 (VOUT)
unnamed: L3.1, U5.5 (VOUT)
unnamed: L4.2, U7.3 (RF_IN)
unnamed: Q2.3 (S), R13.1
unnamed: Q2.5 (G), Q2.6 (D), R12.2
unnamed: R5.1, U1.18 (SAFEBOOT_N)
unnamed: R7.2, U2.5 (PROG)
unnamed: R8.2, U1.9 (RESET_N)
unnamed: R10.2, SW1.1
PWR_BUT: C11.1, IC1.18 (P1.0), R10.1
VBUS: C6.1, FB1.2, IC1.53 (VBUS), U2.4 (VDD)
VUSB: C17.1, IC1.54 (VUSB)
~CHG: IC1.19 (P1.1), U2.1 (CE)

Notes on the sheet:
Possible parts: B39162B8813P810 AFS14A34-1588.66-T3

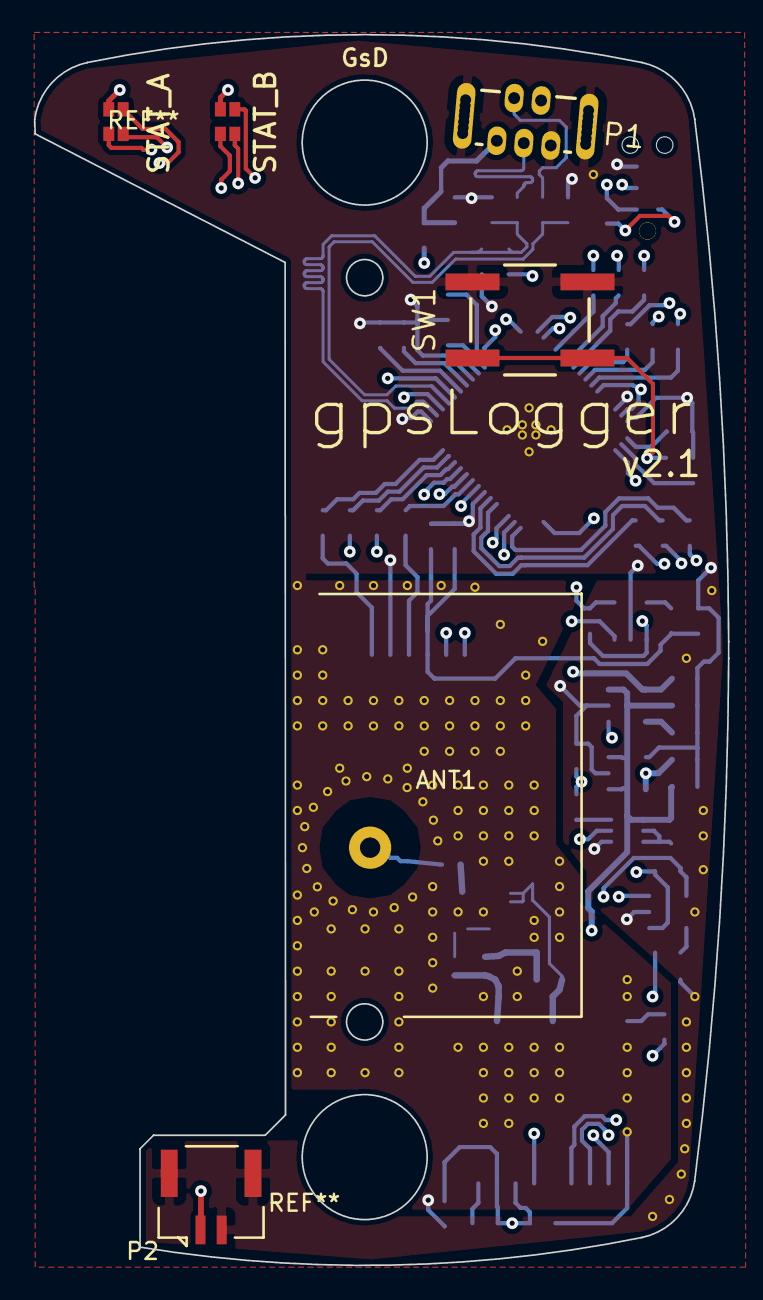
[picture p18: board gpsLogger.kicad_pcb from above]

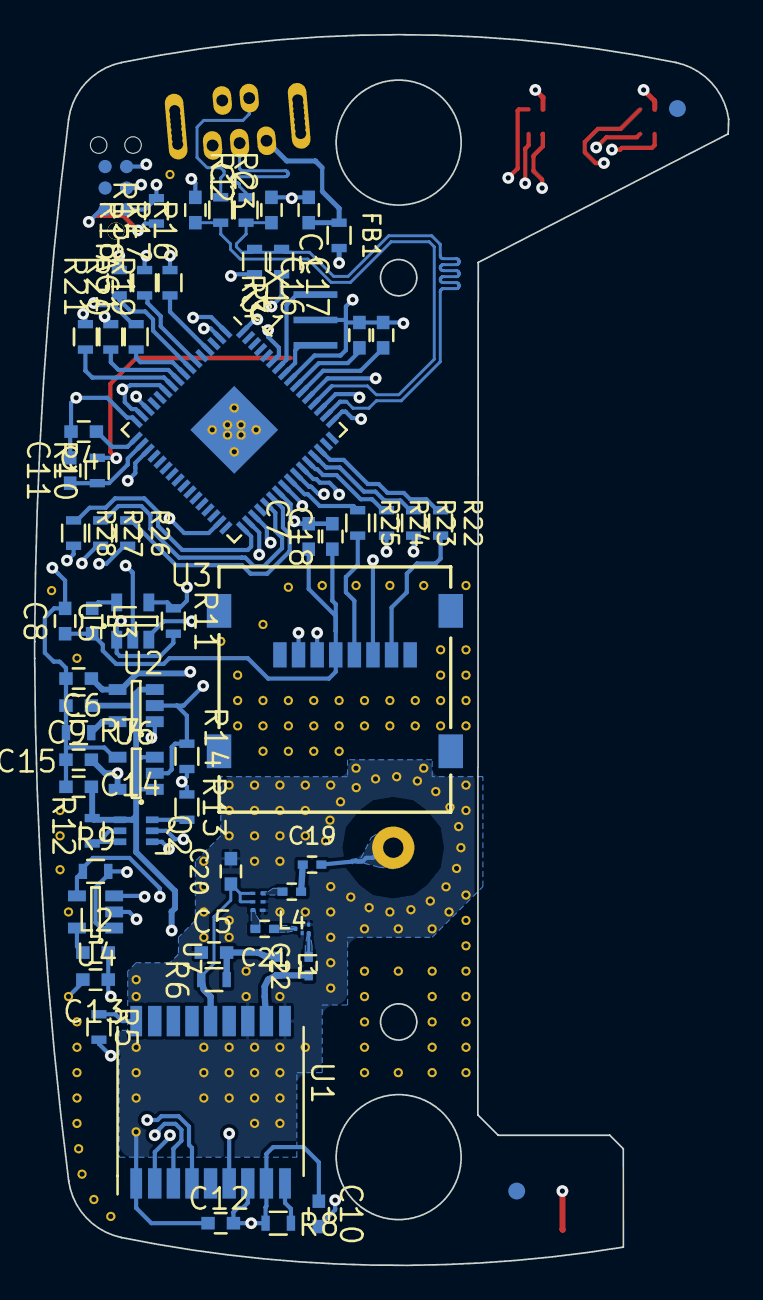
[picture p19: board gpsLogger.kicad_pcb from below]

Board: 4 copper layers, 41.0 x 72.8 mm, 73 parts (67 on the bottom side), 71 nets.
