gregdavill/gpsLogger/(commit log)

2016-01-09 Added initial PCB files.
    [gpsLogger.kicad_pcb, gpsLogger.sch]
2016-01-16 Added USB vertical footprint. uSD card footprint. Did schematic, started rough PCB
    [_saved_gpsLogger.sch, gpsLogger.kicad_pcb]
2016-01-17 Added LED footprint, and Beagle GPS logo. Schematic done, PCB done.
    [gpsLogger.kicad_pcb, gpsLogger.sch]
2016-04-17 Created Gerbers
    [_saved_gpsLogger.sch, gpsLogger.kicad_pcb, gpsLogger.sch]
2016-04-17 Bug fix: Handle Safely remove / no host power supplies
    [main.c]
2016-04-17 On board NMEA to KML working.
2016-04-17 Fixed LED blinking green, while turning off device
    [gps.c]
2016-04-17 Corrected timestamp from GPS, increase NMEA ping-pong buffer size
    [gps.c]
2016-04-17 bug fix, buffer index overflow
    [gps.c]
2016-04-17 bug fix, LED stays green while GPS fix is active.
    [gps.c]
2016-04-17 bug fix, fix fattime parameters
    [mmc.c]
2016-04-17 Added very basic timezone correction. Only adds fixed time of 9:30 for ACST time.
    [mmc.c]
2016-04-17 moved timezone correction into gps_utils
    [gps_util.c, gps_util.h, mmc.c]
2016-04-17 bug fix, fixup some stupid mistakes.
    [gps.c, gps_util.c]
2016-04-17 Increase to NMEA update rate, now trialing at 5Hz
2016-04-22 Changed 5Hz to 2Hz. to stay within 9600baud bandwidth
2016-06-28 Add git commit to make process. Fix invald date printed on log files.
    [gps.c]
2016-06-28 Added f_sync to gps_log file. Added case where two NMEA logs have the same name. (prepand dup with _1)
2016-06-28 Removed CRC check on incomming GPS data, bug found in the calculation
    [gps.c, gps_util.c, main.c]
2016-11-15 Updated GPS functions. Fixed error with duplicate files. Corrected GLONASS RMC capture
    [gps.c, gps_util.c, main.c]
2017-02-11 Updates to ublox GPS handler, error checking, and first f_sync form powerup
    [gps.c, gps_util.c, hal.c, hal.h, main.c]
2017-06-17 'Merge' Hardware changes mistakely made on Mark3 branch
    [gpsLogger.csv, gpsLogger.kicad_pcb, gpsLogger.sch]
2017-06-18 Adde error output on LEDs and updated structure of program
    [main.c]
2017-07-01 Updated Firmware added file time to filename. Added compatibility layer to hal for LEDs based of GPS installed. Added code to reboot into bootloader when firmware found. added code to remove firmware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
    [gps.c, gps.h, gps_util.c, gps_util.h, hal.c, hal.h, main.c, mmc.c]
2017-07-01 Fix to bootloader flow to enable booting of app after error (No card/no File)
    [main.c]
2017-07-29 Formatting changes. Fixed bug with date validity test, updates to initialisation of variables
    [gps.c, gps_util.c]
2021-10-18 Move v2.1 hw into subfolder
    [gpsLogger.kicad_pcb, gpsLogger.kicad_sch]
2021-10-18 Add initial v2.3 hw
    [10132328_usbc_vertical.step, EVQ-P1-9FKYD_P04_9P1-05M.STEP, FH34SRJ-6S-0.5SH.igs, gps-logger-gnss.kicad_pcb, gps-logger-gnss.kicad_sch, gps-logger-main.kicad_pcb, gps-logger-main.kicad_sch, msp430.kicad_sch]
2021-10-18 Remove old files
    [gpsLogger.csv, gpsLogger.kicad_pcb, gpsLogger.sch]
2021-10-19 Update r2.3
    - Add make panel KiKit script
    - Add production gerbers
    [gps-logger-gnss.kicad_pcb, gps-logger-main.kicad_pcb, pmic.kicad_sch]
2021-10-19 Update PCBs to remove small vias
    - Regenerate 1x panel
    - Add gerbers
    [gps-logger-gnss.kicad_pcb, gps-logger-main.kicad_pcb]
2022-02-14 Fix incorrect pin definition
    [gps.c, hal.c]
2022-02-14 hw 2.3.a: New hw revision
    - Fix GNSS-cipo signal
    - Fix reversed pins to gnss connector
    - Update label with current date
    - Update version label
    - Change RGB LED labels
    - Generate gerbers
    [10132328_usbc_vertical.step, EVQ-P1-9FKYD_P04_9P1-05M.STEP, FH34SRJ-6S-0.5SH.igs, gps-logger-main.kicad_pcb, gps-logger-main.kicad_sch, msp430.kicad_sch, pmic.kicad_sch, sdmmc.kicad_sch]
2022-02-14 hw 2.3.a: Add schematic
